henryeherman/Platypus/doc/img/FT2232H.jpg

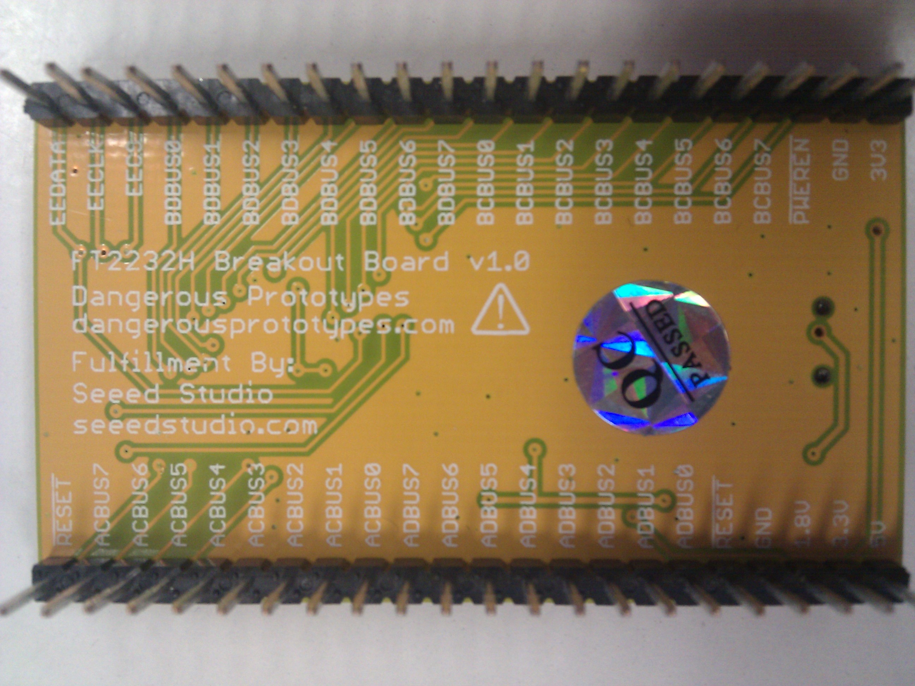
doc/img/FT2232H.jpg
