henryeherman/Platypus/doc/img/FTDI_close0.jpg

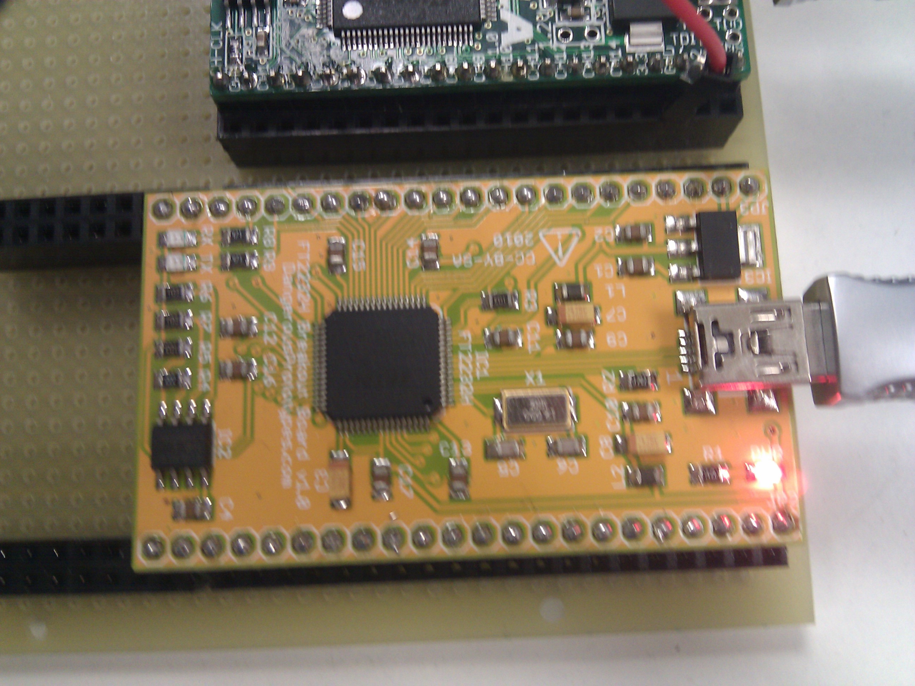
doc/img/FTDI_close0.jpg
