henryeherman/Platypus/doc/img/FTDI_close1.jpg

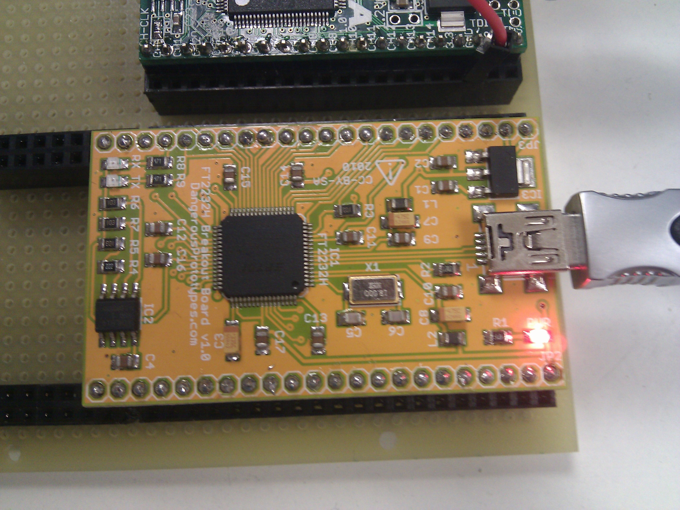
doc/img/FTDI_close1.jpg
