henryeherman/Platypus/doc/img/FTDI_far0.jpg

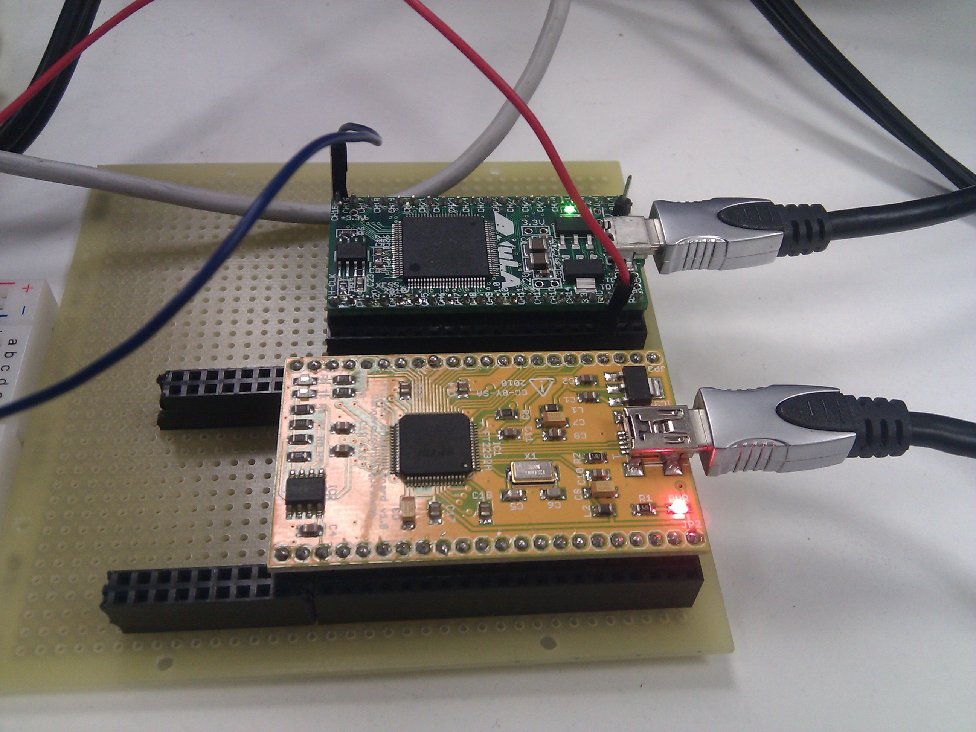
doc/img/FTDI_far0.jpg
