henryeherman/Platypus/doc/img/XULA2FT2232H-2.jpg

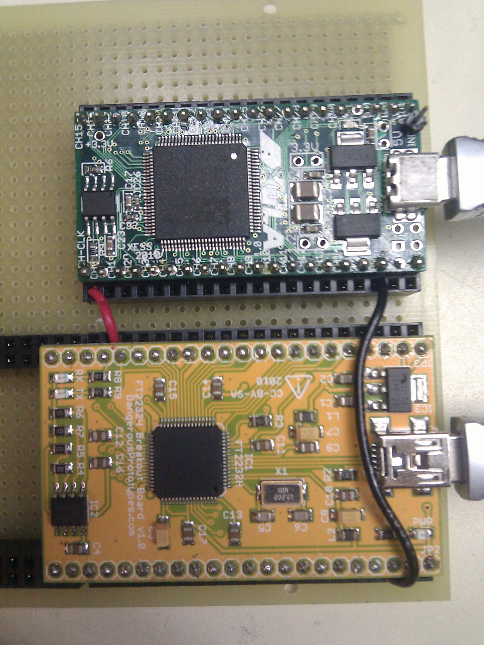
doc/img/XULA2FT2232H-2.jpg
