henryeherman/Platypus/hardware/bom/PlatypusDAQBOM.xls

REV DATE | 9/14/2012 REV2 |  |  |  |  |  |  |  |  |  |  |  |  |  | NOTES: | 9/14/2012 1. Alternate source for AD7606 2. C89 and C90 are now 402 parts 3. Added Gumstix Header Part Numbers
Comment | Description | Designator | Footprint | LibRef | Quantity | Value | Manufacturer | Manufacturer Part Num | Distributor | Dist Part Num | Unit Price | Extended Price | Alternate Distributor | Alt. Dist Part Num
CAP_POL | CAP | C64, C65 | CAP-CAN-SMD-POL-12.5mmDia | CAP_POL | 2 | 1000uF | Panasonic Electronic Components | EEV-FK1E102Q | Digikey | PCE3462CT-ND | 1.61 | 3.22
Res | Resistor | R13, R22 | SM/R_0603 | Res | 2 | 953 | Panasonic Electronic Components | ERJ-3EKF9530V | Digikey | P953HCT-ND | 0.1 | 0.2
RN-8X | MNR15E0RPJ103 | RN3, RN4 | RN-5x603 | RN-8X | 2 | 470 | Rohm Semiconductor | MNR35J5RJ471 | Digikey | MNR35471CT-ND | 0.78 | 1.56
Res | Resistor | R30, R31 | SM/R_0603 | Res | 2 | 330 | Panasonic Electronic Components | ERJ-3EKF3300V | Digikey | P330HCT-ND | 0.1 | 0.2
Res | Resistor | R47, R48 | SM/R_0603 | Res | 2 | 270 | Panasonic Electronic Components | ERJ-3EKF2700V | Digikey | P270HCT-ND | 0.1 | 0.2
Res | Resistor | R14, R18 | SM/R_0603 | Res | 2 | 240 | Panasonic Electronic Components | ERJ-3EKF2400V | Digikey | P240HCT-ND | 0.1 | 0.2
CAP_POL | CAP | C60, C61, C62, C63, C66, C69, C70, C71 | SM/CT_6032_12 | CAP_POL | 8 | 100uF | Kemet | T491C107K016ZT | Digikey | 399-5214-1-ND | 1.34 | 10.72
Res | Resistor | R40 | SM/R_0603 | Res | 1 | 100k | Panasonic Electronic Components | ERJ-3EKF1003V | Digikey | P100KHCT-ND | 0.1 | 0.1
Res | Resistor | JO1, JO2, R5, R6, R7 | SM/R_0603 | Res | 5 | 68 | Panasonic Electronic Components | ERJ-3EKF68R0V | Digikey | P68.0HCT-ND | 0.1 | 0.5
Res | Resistor | R15 | SM/R_0603 | Res | 1 | 53.6k | Panasonic Electronic Components | ERJ-3EKF5362V | Digikey | P53.6KHCT-ND | 0.1 | 0.1
Res | Resistor | R1, R3, R26, R27 | SM/R_0603 | Res | 4 | 49.9 | Panasonic Electronic Components | ERJ-3EKF49R9V | Digikey | P49.9HCT-ND | 0.1 | 0.4
Res | Resistor | R39 | SM/R_0603 | Res | 1 | 47k | Panasonic Electronic Components | ERJ-3EKF4702V | Digikey | P47.0KHCT-ND | 0.1 | 0.1
CAP | CAP | C29, C51 | SM/C_0603 | CAP | 2 | 27pF | Kemet | C0603C270J3GACTU | Digikey | 399-9053-1-ND | 0.1 | 0.2
CAP | CAP | C89, C90 | SM/C_0402 | CAP | 2 | 22pF | TDK Corporation | C1005C0G1H220J | Digikey | 445-1239-1-ND | 0.1 | 0.2
Res | Resistor | R28, R33 | SM/R_0603 | Res | 2 | 12k4 | Panasonic Electronic Components | ERJ-3EKF1242V | Digikey | P12.4KHCT-ND | 0.1 | 0.2
Res | Resistor | R2 | SM/R_0603 | Res | 1 | 12k | Panasonic Electronic Components | ERJ-3EKF1202V | Digikey | P12.0KHCT-ND | 0.1 | 0.1
CAP | CAP | C2_UDAS1, C2_UDAS2, C2_UDAS3, C2_UDAS4, C2_UDAS5, C2_UDAS6, C2_UDAS7, C2_UDAS8 | SM/C_0805 | CAP | 8 | 10uF | Taiyo Yuden | TMK212BBJ106KG-T | Digikey | 587-2985-1-ND | 0.38 | 3.04
CAP | CAP | C9_UDAS1, C9_UDAS2, C9_UDAS3, C9_UDAS4, C9_UDAS5, C9_UDAS6, C9_UDAS7, C9_UDAS8 | SM/C_0603 | CAP | 8 | 10uF | TDK Corporation | C1608X5R1A106M | Digikey | 445-6853-1-ND | 0.44 | 3.52
CAP_POL | CAP | C54, C55, C58, C59, C95 | SM/C_POL_0805 | CAP_POL | 5 | 10uF | Taiyo Yuden | TMK212BBJ106KG-T | Digikey | 587-2985-1-ND | 0.38 | 1.9
Res | Resistor | R32, R37, R38, R46 | SM/R_0603 | Res | 4 | 10K | Panasonic Electronic Components | ERJ-3EKF1002V | Digikey | P10.0KHCT-ND | 0.1 | 0.4
RN-8X | MNR15E0RPJ103 | RN1, RN2 | RN-5x603 | RN-8X | 2 | 10k | Rohm Semiconductor | MNR15E0RPJ103 | Digikey | MNR15103CT-ND | 0.61 | 1.22
Res | Resistor | R23 | SM/R_0603 | Res | 1 | 9.76k | Panasonic Electronic Components | ERJ-3EKF9761V | Digikey | P9.76KHCT-ND | 0.1 | 0.1
Res | Resistor | R16 | SM/R_0603 | Res | 1 | 6.19k | Panasonic Electronic Components | ERJ-3EKF6191V | Digikey | P6.19KHCT-ND | 0.1 | 0.1
Inductor |  | L12 | SM/L_0805 | Inductor | 1 | 4.7uH | Taiyo Yuden | BRC2012T4R7MD | Digikey | 587-2907-1-ND | 0.28 | 0.28
CAP | CAP | C19, C20, C23, C77, C79 | SM/C_0603 | CAP | 5 | 4.7uF | Taiyo Yuden | EMK107ABJ475KA-T | Digikey | 587-2786-1-ND | 0.26 | 1.3
Res | Resistor | R8, R9, R10, R11, R12, R34, R36, R45, R51 | SM/R_0603 | Res | 9 | 4K7 | Panasonic Electronic Components | ERJ-3EKF4701V | Digikey | P4.70KHCT-ND | 0.1 | 0.9
Res | Resistor | R24 | SM/R_0603 | Res | 1 | 2.49k | Panasonic Electronic Components | ERJ-3EKF2491V | Digikey | P2.49KHCT-ND | 0.1 | 0.1
Res | Resistor | R17, R25 | SM/R_0603 | Res | 2 | 2k | Panasonic Electronic Components | ERJ-3EKF2001V | Digikey | P2.00KHCT-ND | 0.1 | 0.2
Inductor |  | L1, L2, L13 | SM/L_0805 | Inductor | 3 | 1uH | TDK Corporation | GLFR2012T1R0M-LR | Digikey | 445-3611-1-ND | 0.25 | 0.75
CAP | CAP | C1_UDAS1, C1_UDAS2, C1_UDAS3, C1_UDAS4, C1_UDAS5, C1_UDAS6, C1_UDAS7, C1_UDAS8, C3_UDAS1, C3_UDAS2, C3_UDAS3, C3_UDAS4, C3_UDAS5, C3_UDAS6, C3_UDAS7, C3_UDAS8, C4_UDAS1, C4_UDAS2, C4_UDAS3, C4_UDAS4, C4_UDAS5, C4_UDAS6, C4_UDAS7, C4_UDAS8, C5_UDAS1, C5_UDAS2, C5_UDAS3, C5_UDAS4, C5_UDAS5, C5_UDAS6, C5_UDAS7, C5_UDAS8, C6_UDAS1, C6_UDAS2, C6_UDAS3, C6_UDAS4, C6_UDAS5, C6_UDAS6, C6_UDAS7, C6_UDAS8, C7_UDAS1, C7_UDAS2, C7_UDAS3, C7_UDAS4, C7_UDAS5, C7_UDAS6, C7_UDAS7, C7_UDAS8, C8_UDAS1, C8_UDAS2, C8_UDAS3, C8_UDAS4, C8_UDAS5, C8_UDAS6, C8_UDAS7, C8_UDAS8, C10, C11, C12, C13, C14, C15, C16, C17, C18, C21, C22, C24, C25, C26, C27, C28, C30, C31, C32, C33, C34, C35, C36, C37, C38, C39, C40, C41, C42, C43, C44, C45, C46, C47, C48, C49, C50, C52, C53, C56, C57, C72, C75, C93, C94, C96, C97, C98 | SM/C_0603 | CAP | 104 | 1uF | TDK Corporation | C1608Y5V1C105Z | Digikey | 445-1327-1-ND | 0.0231 | 2.4024
Res | Resistor | R29 | SM/R_0603 | Res | 1 | 1M | Panasonic Electronic Components | ERJ-3EKF1004V | Digikey | P1.00MHCT-ND | 0.1 | 0.1
Res | Resistor | R4, R19, R20, R21, R35 | SM/R_0603 | Res | 5 | 1K | Panasonic Electronic Components | ERJ-3EKF1001V | Digikey | P1.00KHCT-ND | 0.1 | 0.5
CAP | CAP | C76, C78, C80, C81, C82, C83, C84, C85, C86, C87, C88, C91 | SM/C_0402 | CAP | 12 | 0.1uF | TDK Corporation | C1005Y5V1E104Z | Digikey | 445-3445-1-ND | 0.024 | 0.288
CAP | CAP | C92 | SM/C_0603 | CAP | 1 | 0.1uF | TDK Corporation | C1608X7R1E104K | Digikey | 445-1316-1-ND | 0.1 | 0.1
CAP | CAP | C67, C68, C73, C74 | SM/C_0603 | CAP | 4 | 0.047uF | TDK Corporation | C1608X7R1H473K | Digikey | 445-1313-1-ND | 0.1 | 0.4
0031.8221 | FUSEHOLDER BLACK FOR SMD 5X20MM | F1 | SCHURTER/SMD/2 PADS/0031.8221 | 2105 | 1 |  | Schurter Inc | 31.8221 | Digikey | 486-1260-ND | 1.01 | 1.01
10 pos spst switch 219-10MST |  | SW1 | SW-10pos-SPST | 10 pos spst switch 219-10MST | 1 |  | C&K Components | BPA10SB | Digikey | CKN6149-ND | 2.38 | 2.38
22uH | INDUCTOR SHIELD PWR 22UH 10145 | L3, L4, L5, L6, L7, L8, L9, L10, L11 | G_JMETRIC/TDK/SLE10145 | 1660 | 9 |  | TDK Corporation | SLF10145T-220M1R9-PF | Digikey | 445-1981-1-ND | 1.17 | 10.53
24pinHeader |  | CON1, CON2, CON3, CON4, CON5, CON6, CON7, CON8, CON9, CON10 | CONN-RECEPT-24PIN | 24pinHeader | 10 |  | Molex Connector Corporation | 87832-2420 | Digikey | WM18646-ND | 3.1 | 31
74HC541 |  | U14 | TSSOP-20PIN-74HC541 | 74HC541(Non-inverting buffer) | 1 |  | Texas Instruments | SN74HC541PWR | Digikey | 296-8335-1-ND | 0.26 | 0.26
93C46A |  | U4, U21 | SOT23-93C46-EEPROM-Microchip | 93CX6-EEPROM | 2 |  | Microchip Technology | 93C46BT-I/OT | Digikey | 93C46BT-I/OTCT-ND | 0.32 | 0.64
AD7606 |  | U1_UDAS1, U1_UDAS2, U1_UDAS3, U1_UDAS4, U1_UDAS5, U1_UDAS6, U1_UDAS7, U1_UDAS8 | LQFP-64Pins-Analog | AD7606 | 8 |  | Analog Devices | AD7606BSTZ | Digikey | AD7606BSTZ-RLCT-ND | 30.2 | 241.6 | Newark | 76R7614
DRQ127-100 |  | T1 | DRQ127-100 | DRQ127-100-XFORM-1:1 | 1 |  | Cooper Bussmann | DRQ127-100-R | Digikey | 513-1143-1-ND | 2.72 | 2.72
FSUSB42 |  | U17 | MSOP-10LEAD-FairchildSemi-USBMux | FSUSB42 | 1 |  | Fairchild Semiconductor | FSUSB42MUX | Digikey | FSUSB42MUXCT-ND | 1.7 | 1.7
FT2232H |  | U3 | LQFP-64PIN-FTDI-FT2232H | FT2232H | 1 |  | FTDI | FT2232HL-REEL | Digikey | 768-1024-1-ND | 6.71 | 6.71
FT232RQ |  | U19 | QFN32-FT232RQ | FT232R | 1 |  | FTDI | FT232RQ-REEL | Digikey | 768-1008-1-ND | 4.5 | 4.5
LAN9221 |  | U15 | QFN-56Pin-SMSC-LAN9221 | LAN9221 | 1 |  | SMSC | LAN9221-ABZJ | Mouser | 886-LAN9221-ABZJ | 10.4 | 10.4
LED |  | D1, D2, D4, D5, D6 | LED-1206 | LED | 5 |  | Lite-On Inc | LTST-C150GKT | Digikey | 160-1169-1-ND | 0.34 | 1.7
LEDS |  | DA1 | LEDBARGRAPH | LEDBARGRAPH | 1 |  | Lite-On Inc | LTA-1000HR | Digikey | 160-1066-ND | 1.26 | 1.26
LM2941 |  | U10 | T0-263- 5Lead - National Semi - LM2941 | LM2941-LDO Regulator | 1 |  | National Semiconductor | LM2941SX/NOPB | Digikey | LM2941SXCT-ND | 1.79 | 1.79
LM2991 |  | U12 | T0-263 5Lead SMP - National Semi - LM2991S | LM2991-Negative LDO Regulator | 1 |  | National Semiconductor | LM2991SX/NOPB | Digikey | LM2991SXCT-ND | 3.69 | 3.69
LT1129-3.3 |  | U6 | SOT223-3Lead-STPackage-LinearTechLT1129-3.3 | LT1129-3.3 | 1 |  | Linear Technology | LT1129CST-3.3#PBF | Digikey | LT1129CST-3.3#PBF-ND | 4.52 | 4.52
LT1129-5 |  | U7 | SOT223-3Lead-STPackage-LinearTechLT1129-3.3 | LT1129-5 | 1 |  | Linear Technology | LT1129CST-5#PBF | Digikey | LT1129CST-5#PBF-ND | 4.52 | 4.52
LT1761-1.8 |  | U20 | TSOT-23-5Lead-LTC3406A | LT1761-X | 1 |  | Linear Technology | LT1761ES5-1.8#TRMPBF | Digikey | LT1761ES5-1.8#TRMPBFCT-ND | 2.39 | 2.39
LT1761-2.5 |  | U8, U9 | TSOT-23-5Lead-LTC3406A | LT1761-X | 2 |  | Linear Technology | LT1761ES5-2.5#TRMPBFCT-ND | Digikey | LT1761ES5-2.5#TRMPBFCT-ND | 2.39 | 4.78
LTC1370 |  | U11, U13 | DDPak-7Lead-RPackage-linear | LT1370 | 2 |  | Linear Technology | LT1370CR#PBF | Digikey | LT1370CR#PBF-ND | 12.19 | 24.38
M25P40 |  | U5 | SOIC-8pin-micron-M25P40-Flash | M25P40-Flash | 1 |  | Micron Technology Inc | M25P40-VMW6TGB | Digikey | M25P40-VMW6TGBCT-ND | 0.78 | 0.78
MagJack |  | ETHR1 | MagJack | MAGJACK-SI-60062 | 1 |  | Stewart Connector | SI-60062-F | Digikey | 380-1106-ND | 5.57 | 5.57
MAX3002 |  | U18 | TSSOP-20Lead-MAXIM | MAX3002 | 1 |  | Maxim Integrated | MAX3002EUP+ | Digikey | MAX3002EUP+-ND | 4.6 | 4.6
MBRS360BT3G |  | D3, D7 | DPAK-MBRD835L | Schottky Diode | 2 |  | On Semiconductor | MBRD835LT4G | Digikey | MBRD835LT4GOSCT-ND | 0.72 | 1.44
MOM-SW-NO |  | S1, S2 | MOM-SW | MOM-BUT | 2 |  | C&K Components | PTS525SM10SMTR LFS | Digikey | CKN9104CT-ND | 0.61 | 1.22
OSC |  | XCO1 | CB3&CB3LV-XCO | XCO | 1 |  | CTS-Frequency Controls | CB3LV-3C-32M0000 | Digikey | CTX277LVCT-ND | 1.85 | 1.85
Overo | Gumstix Overo COM | U16 | OVERO | Overo | 1 |  | Gumstix | KIT0023 | Gumstix | KIT0023 | 25 | 25
PGB1 |  | ESD1 | SOT23-PGB1-ESD | PGB102ST23 | 1 |  | Littlefuse Inc | PGB102ST23WR | Digikey | F2596CT-ND | 0.94 | 0.94
Res | Resistor | JC1, JC2, JC3, JO3, JO4, JO5, JO6, R41, R42, R43, R44, R49, R50 | SM/R_0603 | Res | 13 | 0 | Panasonic Electronic Components | ERJ-3GEY0R00V | Digikey | P0.0GCT-ND |  | 0.02
SI4423DY-T1-E3 | mosfet,p ch,20v,10a,8soic; transistor polarity:p channel; | Q3 | SOIC-8-Lead-Vishay-PFET | 2390 | 1 |  | Vishay Siliconix | SI4423DY-T1-E3 | Digikey | SI4423DY-T1-E3CT-ND | 2.35 | 2.35
SMAJ20CA-TP | TVS 400W 12V BIDIRECT SMA | TVS1 | D0-214AC | 2519 | 1 |  | Micro Commercial Co | SMAJ20CA-TP | Digikey | SMAJ20CA-TPMSCT-ND | 0.55 | 0.55
TERM BLOCK 2POS |  | VPWR1 | Conn-ScrewTerminal-2pin-Phoenix | 2Pin-PhoenixTerminalBlock | 1 |  | Phoenix Contact | 1757242 | Digikey | 277-1106-ND | 0.48 | 0.48
USB MiniB | Mini USB | USB, USB1 | USB-MINIB | USB MiniB | 2 |  | Hirose Electric Co Ltd | UX60A-MB-5ST | Digikey | H2961CT-ND | 1.25 | 2.5
XC3S500E-PQFP208 |  | U2 | PQFP-208PIN-PQ208-PQG208 | XC3S500E-PQ208 | 1 |  | Xilinx Inc | XC3S500E-4PQG208C | Digikey | 122-1520-ND | 27.6 | 27.6
XTAL-ABMM |  | X2 | ABMM-Crystal | XTAL-ABMM | 1 |  | Abracon Corporation | ABMM-25.000MHZ-B2-T | Digikey | 535-9161-1-ND | 1.2 | 1.2
XTAL-FA238V |  | X1 | XTAL 12MHz SMD | XTAL-FA238V | 1 |  | EPSON | FA-238V 12.0000MB-K3 | Digikey | SER3682CT-ND | 2.25 | 2.25
 |  |  |  | Part Count | 299 |  |  |  |  |  | Total Cost | 476.6304
