henryeherman/Platypus/(list of files, cad)

Other CAD files:
solidmodels/BoardOutline-1.dwg
solidmodels/BoardOutline-autocad2002.dwg
solidmodels/BoardOutline-autocad2007.dwg
solidmodels/BoardOutline-1.idw
solidmodels/BoardOutline.ipt
solidmodels/DaughterBoardOutline.ipt
