henryeherman/Platypus/(list of files, drawings)

Other design files:
hardware/PlatypusDAQ.PrjPCB
hardware/schematics/DataAquisitionSystem.SchDoc
hardware/schematics/GumstixEthernetInterface.SchDoc
hardware/schematics/GumstixInterface.SchDoc
hardware/schematics/PlatypusDAQ.PcbDoc
hardware/schematics/PlatypusDAQ.SchDoc
hardware/schematics/Power_Supply.SchDoc
