henryeherman/Platypus/(commit log)

2012-06-28 Initial add ft2232_rx switch to asynchronous fifo
2012-07-20 Fixed issue causing missed read data
    [daqpacketizer.v, daqpacketizer_tb.v]
2012-08-01 Add fttxdemo - Demonstrates FT2232H Synchronous FIFO (FT245 Mode) as well as build setup for Xilinx command line tools, currently untested
2012-09-16 Added PlatypusDAQ PCB design
    [BoardOutline-1.dwg, BoardOutline-1.idw, BoardOutline-autocad2002.dwg, BoardOutline-autocad2007.dwg, BoardOutline.ipt, DataAquisitionSystem.SchDoc, DaughterBoardOutline.ipt, GumstixEthernetInterface.SchDoc]
2013-02-22 Tested trigger on XULA Board
2013-02-25 Packetizer inserts preamble
